akademiaelektroniki/steam-clock/doc/pcb/atomic_clk/atomic_clk.kicad_pcb

## KiCad design doc/pcb/atomic_clk/atomic_clk.kicad_pcb (2019-07-22)

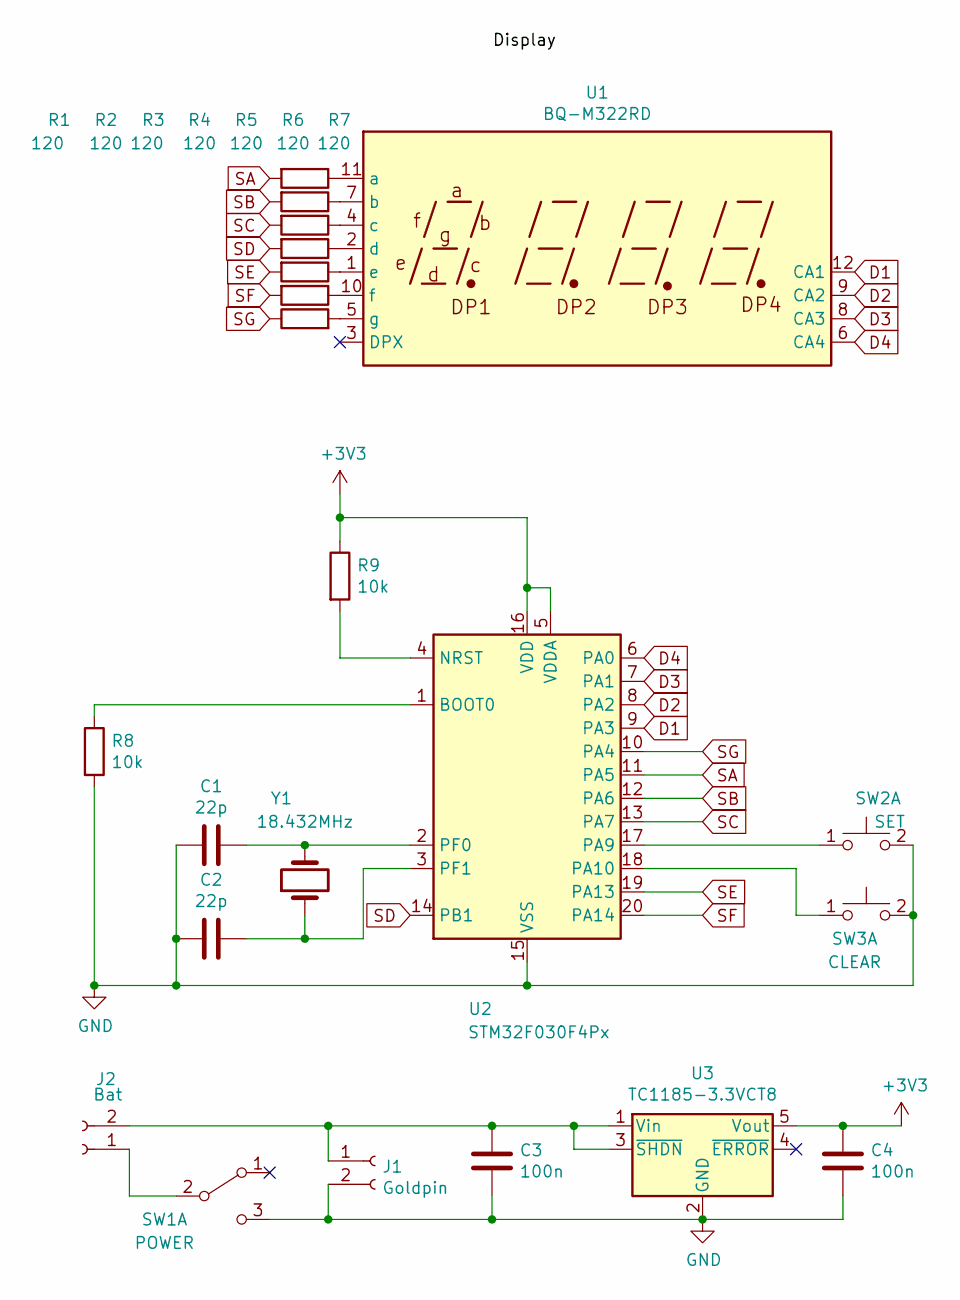
[picture p1: schematic atomic_clk.sch, Steam_Clock]

Parts:
C1, C2: 22p; C_0603_1608Metric_Pad1.05x0.95mm_HandSolder
C3, C4: 100n; C_0603_1608Metric_Pad1.05x0.95mm_HandSolder
J1: Goldpin; PinHeader_1x02_P2.54mm_Vertical
J2: Bat; PinHeader_1x02_P1.27mm_Vertical
R1, R2, R3, R4, R5, R6, R7: 120; R_0603_1608Metric
R8, R9: 10k; R_0603_1608Metric
SW1: POWER; SW_CuK_JS202011CQN_DPDT_Straight
SW2: SET; SW_SPST_CK_RS282G05A3
SW3: CLEAR; SW_SPST_CK_RS282G05A3
U1: BQ-M322RD; MAN3420A
U2: STM32F030F4Px; TSSOP-20_4.4x6.5mm_P0.65mm
U3: TC1185-3.3VCT8; SOT-23-5
Y1: 18.432MHz; Crystal_HC49-4H_Vertical

Connections:
+3V3: C4.1, R9.1, U2.5 (VDDA), U2.16 (VDD), U3.5 (Vout)
D1: U1.12 (CA1), U2.9 (PA3)
D2: U1.9 (CA2), U2.8 (PA2)
D3: U1.8 (CA3), U2.7 (PA1)
D4: U1.6 (CA4), U2.6 (PA0)
GND: C1.2, C2.2, C3.2, C4.2, J1.2, R8.2, SW1.3 (C), SW2.2 (D), SW3.2 (D), U2.15 (VSS), U3.2 (GND)
unnamed: C1.1, U2.2 (PF0), Y1.2
unnamed: C2.1, U2.3 (PF1), Y1.1
unnamed: C3.1, J1.1, J2.2, U3.1 (Vin), U3.3 (~SHDN)
unnamed: J2.1, SW1.2 (B)
unnamed: R1.1, U1.11 (a)
unnamed: R2.1, U1.7 (b)
unnamed: R3.1, U1.4 (c)
unnamed: R4.1, U1.2 (d)
unnamed: R5.1, U1.1 (e)
unnamed: R6.1, U1.10 (f)
unnamed: R7.2, U1.5 (g)
unnamed: R8.1, U2.1 (BOOT0)
unnamed: R9.2, U2.4 (NRST)
unnamed: SW2.1 (C), U2.17 (PA9)
unnamed: SW3.1 (C), U2.18 (PA10)
SA: R1.2, U2.11 (PA5)
SB: R2.2, U2.12 (PA6)
SC: R3.2, U2.13 (PA7)
SD: R4.2, U2.14 (PB1)
SE: R5.2, U2.19 (PA13)
SF: R6.2, U2.20 (PA14)
SG: R7.1, U2.10 (PA4)

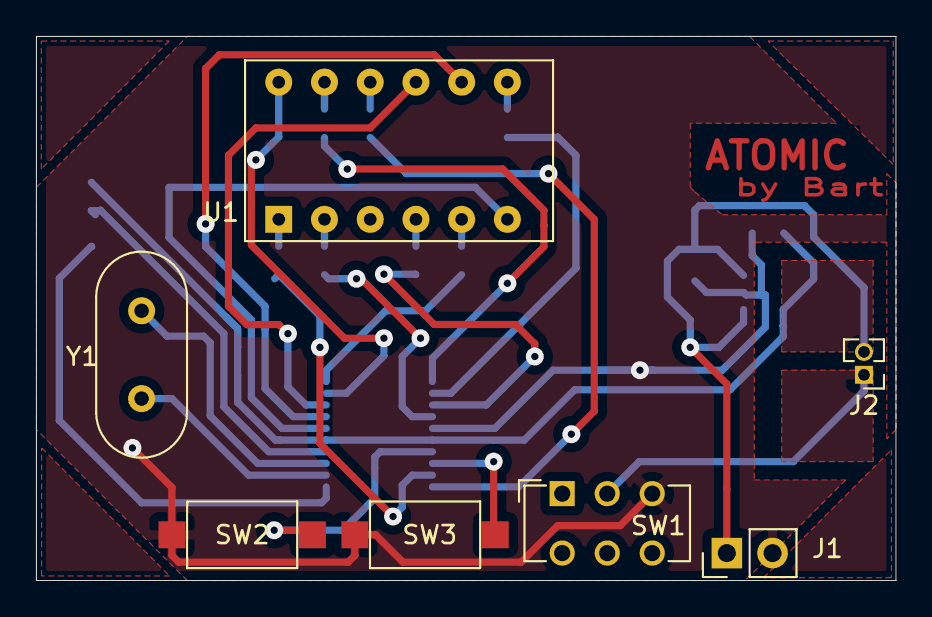
[picture p2: board atomic_clk.kicad_pcb from above]

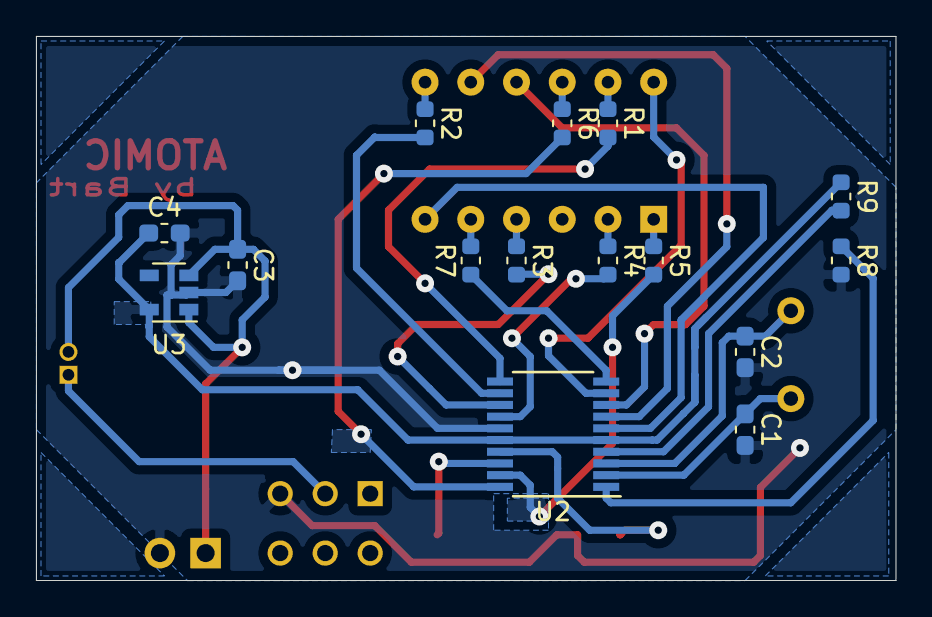
[picture p3: board atomic_clk.kicad_pcb from below]

Board: 2 copper layers, 47.8 x 30.2 mm, 22 parts (15 on the bottom side), 28 nets.
