akademiaelektroniki/steam-clock/Src/main.c

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

/* Includes ------------------------------------------------------------------*/
#include "main.h"

/* USER CODE BEGIN PTD */
RTC_TimeTypeDef gDate;
RTC_TimeTypeDef gTime;

RTC_TimeTypeDef sDate;
RTC_TimeTypeDef sTime;
/* USER CODE END PTD */

/* USER CODE BEGIN PD */

//Common anode display
//segments. dot is not user, so we have 7 segments, from A to G.
//Segments are cathodes, so you can turn it on by pulling to ground.
#define SA_ON HAL_GPIO_WritePin(SA_GPIO_Port, SA_Pin, 0)
#define SB_ON HAL_GPIO_WritePin(SB_GPIO_Port, SB_Pin, 0)
#define SC_ON HAL_GPIO_WritePin(SC_GPIO_Port, SC_Pin, 0)
#define SD_ON HAL_GPIO_WritePin(SD_GPIO_Port, SD_Pin, 0)
#define SE_ON HAL_GPIO_WritePin(SE_GPIO_Port, SE_Pin, 0)
#define SF_ON HAL_GPIO_WritePin(SF_GPIO_Port, SF_Pin, 0)
#define SG_ON HAL_GPIO_WritePin(SG_GPIO_Port, SG_Pin, 0)

#define SA_OFF HAL_GPIO_WritePin(SA_GPIO_Port, SA_Pin, 1)
#define SB_OFF HAL_GPIO_WritePin(SB_GPIO_Port, SB_Pin, 1)
#define SC_OFF HAL_GPIO_WritePin(SC_GPIO_Port, SC_Pin, 1)
#define SD_OFF HAL_GPIO_WritePin(SD_GPIO_Port, SD_Pin, 1)
#define SE_OFF HAL_GPIO_WritePin(SE_GPIO_Port, SE_Pin, 1)
#define SF_OFF HAL_GPIO_WritePin(SF_GPIO_Port, SF_Pin, 1)
#define SG_OFF HAL_GPIO_WritePin(SG_GPIO_Port, SG_Pin, 1)

//digits. We have 4, from 1 to 4. Digits are anodes, so you can turn it on by pulling
//to supply voltage
#define D1_ON HAL_GPIO_WritePin(D1_GPIO_Port, D1_Pin, 1)
#define D2_ON HAL_GPIO_WritePin(D2_GPIO_Port, D2_Pin, 1)
#define D3_ON HAL_GPIO_WritePin(D3_GPIO_Port, D3_Pin, 1)
#define D4_ON HAL_GPIO_WritePin(D4_GPIO_Port, D4_Pin, 1)

#define D1_OFF HAL_GPIO_WritePin(D1_GPIO_Port, D1_Pin, 0)
#define D2_OFF HAL_GPIO_WritePin(D2_GPIO_Port, D2_Pin, 0)
#define D3_OFF HAL_GPIO_WritePin(D3_GPIO_Port, D3_Pin, 0)
#define D4_OFF HAL_GPIO_WritePin(D4_GPIO_Port, D4_Pin, 0)

//turning off
#define D_OFF D1_OFF; D2_OFF; D3_OFF; D4_OFF
#define S_OFF SA_OFF; SB_OFF; SC_OFF; SD_OFF; SE_OFF; SF_OFF; SG_OFF
#define ALL_OFF D_OFF; S_OFF

//display delay
#define WAIT HAL_Delay(1)

//buttons
#define CLEAR HAL_GPIO_ReadPin(CLEAR_GPIO_Port, CLEAR_Pin) == 0
#define SET HAL_GPIO_ReadPin(SET_GPIO_Port, SET_Pin) == 0

/* USER CODE END PD */

RTC_HandleTypeDef hrtc;

/* USER CODE BEGIN PV */
int hours;
int minutes;
int seconds;
int settings = 0; //settings mode
int set_delay = 100;
int active_time = 0;
int mode = 1; //0- force, 1- ondemand
/* USER CODE END PV */

void SystemClock_Config(void);
static void MX_GPIO_Init(void);
static void MX_RTC_Init(void);
/* USER CODE BEGIN PFP */
void display(int position, int number);
void display_twice(int position, int number);
/* USER CODE END PFP */

/**
  * @brief  The application entry point.
  * @retval int
  */
int main(void)
{
  /* MCU Configuration--------------------------------------------------------*/

  /* Reset of all peripherals, Initializes the Flash interface and the Systick. */
  HAL_Init();

  /* Configure the system clock */
  SystemClock_Config();

  /* Initialize all configured peripherals */
  MX_GPIO_Init();
  MX_RTC_Init();
  /* Infinite loop */
  /* USER CODE BEGIN WHILE */
	while (1) {
	
	if(SET){
	
		active_time = 0;
		HAL_Delay(50);

	}

	while(active_time < 10 || mode == 0){
		//___________________SECTION 1 -setting clock

		if (CLEAR) { //clear button enter clock set.
			settings = 1;
			HAL_Delay(300);

		}
		//if set are bigger than 0, you are entering setting mode.
		while (settings >= 1) {

			if (CLEAR) {
				settings++;
				if (settings >= 5) {
					settings = 0;
				}
				HAL_Delay(300);
			}

			//reading from RTC also in settings mode
			HAL_RTC_GetDate(&hrtc, &gDate, RTC_FORMAT_BIN);
			HAL_RTC_GetTime(&hrtc, &gTime, RTC_FORMAT_BIN);
			hours = gTime.Hours;
			minutes = gTime.Minutes;
			seconds = gTime.Seconds;

			//display ony this, what you are setting
			if (settings == 1) {
				display_twice(1, hours);
			} else if (settings == 2) {
				display_twice(3, minutes);
			} else if (settings == 3) {
				display_twice(3, seconds);
			} else if (settings == 4){
				
				if(mode == 0){
					
					display(2, 10);

				}else if(mode == 1){

					display(2, 11);
				}
			}

			ALL_OFF
			;

			if (settings == 1) {
				if (SET) {
					hours++;
					if (hours >= 24) {
						hours = 0;

					}

					sTime.Hours = hours;
					sTime.Minutes = minutes;
					sTime.Seconds = seconds;
					HAL_RTC_SetDate(&hrtc, &sDate, RTC_FORMAT_BIN);
					HAL_RTC_SetTime(&hrtc, &sTime, RTC_FORMAT_BIN);
					HAL_Delay(set_delay);

				}
			}

			if (settings == 2) {
				if (SET) {
					minutes++;
					if (minutes >= 60) {
						minutes = 0;

					}

					sTime.Hours = hours;
					sTime.Minutes = minutes;
					sTime.Seconds = seconds;
					HAL_RTC_SetDate(&hrtc, &sDate, RTC_FORMAT_BIN);
					HAL_RTC_SetTime(&hrtc, &sTime, RTC_FORMAT_BIN);
					HAL_Delay(set_delay);

				}
			}

			if (settings == 3) {
				if (SET) {
					seconds = 0;
					sTime.Hours = hours;
					sTime.Minutes = minutes;
					sTime.Seconds = seconds;
					HAL_RTC_SetDate(&hrtc, &sDate, RTC_FORMAT_BIN);
					HAL_RTC_SetTime(&hrtc, &sTime, RTC_FORMAT_BIN);
					HAL_Delay(set_delay);

				}

			}

			if(settings ==4){
				
				if(SET) {
					if(mode == 0){
					
						mode = 1;

					}else if(mode == 1){

						mode = 0;
					
					}
					HAL_Delay(set_delay);
				}
			}
		}

		//___________________SECTION 2 -display clock
		if (SET) {
			display_twice(3, seconds);
			active_time = 0;//reset active time when pressed
		} else {
			display_twice(1, hours);
			display_twice(3, minutes);
		}

		//___________________SECTION 3 -read from RTC
		


		HAL_RTC_GetDate(&hrtc, &gDate, RTC_FORMAT_BIN);
		HAL_RTC_GetTime(&hrtc, &gTime, RTC_FORMAT_BIN);
		
		//after each second counter change, add 1 to counter variable
		//except settings mode and seconds check
		if(seconds != gTime.Seconds && settings == 0 && !SET){

			active_time++;

		}

		hours = gTime.Hours;
		minutes = gTime.Minutes;
		seconds = gTime.Seconds;

		//___________________SECTION 4 -exit active mode

	}

    /* USER CODE END WHILE */

    /* USER CODE BEGIN 3 */
	}
  /* USER CODE END 3 */
}

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
/* USER CODE BEGIN 4 */
void display(int position, int number) {
	ALL_OFF
	;
	int ok = 1;
	switch (position) {
	case 1:
		D1_ON;
		break;
	case 2:
		D2_ON;
		break;
	case 3:
		D3_ON;
		break;
	case 4:
		D4_ON;
		break;
	default:
		ok = 0;		//secure. Dont turn LEDs, if position is different than 1-4
	}
	if (ok == 1) {
		switch (number) {
		case 0:
			SA_ON;
			SB_ON;
			SC_ON;
			SD_ON;
			SE_ON;
			SF_ON;
			break;
		case 1:
			SB_ON;
			SC_ON;
			break;
		case 2:
			SA_ON;
			SB_ON;
			SG_ON;
			SE_ON;
			SD_ON;
			break;
		case 3:
			SA_ON;
			SB_ON;
			SG_ON;
			SC_ON;
			SD_ON;
			break;

		case 4:
			SB_ON;
			SG_ON;
			SF_ON;
			SC_ON;
			break;
		case 5:
			SA_ON;
			SF_ON;
			SG_ON;
			SC_ON;
			SD_ON;
			break;

		case 6:
			SA_ON;
			SF_ON;
			SG_ON;
			SC_ON;
			SE_ON;
			SD_ON;
			break;

		case 7:
			SA_ON;
			SB_ON;
			SC_ON;
			break;

		case 8:
			SA_ON;
			SB_ON;
			SC_ON;
			SD_ON;
			SE_ON;
			SF_ON;
			SG_ON;
			break;

		case 9:
			SA_ON;
			SB_ON;
			SC_ON;
			SD_ON;
			SG_ON;
			SF_ON;
			break;

		case 10://F letter(force mode)
			SA_ON;
			SG_ON;
			SE_ON;
			SF_ON;
			break;

		case 11://O letter(ondemand mode)
			SA_ON;
			SB_ON;
			SC_ON;
			SD_ON;
			SE_ON;
			SF_ON;
			break;


		}
	}
	WAIT;
	ALL_OFF;
}

void display_twice(int position, int number) {
	int first_digit;
	int second_digit;
	ALL_OFF
	;
//brake a number into two digits
	if (number <= 9) {
		first_digit = 0;
		second_digit = number;
	}
	if ((number >= 10) && (number <= 19)) {		//check if number is from range
		first_digit = 1;
		second_digit = number - 10;
	}
	if ((number >= 20) && (number <= 29)) {		//check if number is from range
		first_digit = 2;
		second_digit = number - 20;
	}
	if ((number >= 30) && (number <= 39)) {		//check if number is from range
		first_digit = 3;
		second_digit = number - 30;
	}
	if ((number >= 40) && (number <= 49)) {		//check if number is from range
		first_digit = 4;
		second_digit = number - 40;
	}
	if ((number >= 50) && (number <= 59)) {		//check if number is from range
		first_digit = 5;
		second_digit = number - 50;
	}

	display(position, first_digit);
	display(position + 1, second_digit);

}
/* USER CODE END 4 */
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
