akademiaelektroniki/steam-clock/10_STEAM_CLK.ioc

Mcu.UserName=STM32F030F4Px
PA0.GPIO_Label=D4
PA0.Signal=GPIO_Output
PA1.GPIO_Label=D3
PA1.Signal=GPIO_Output
PA10.GPIO_Label=CLEAR
PA10.Signal=GPIO_Input
PA13.GPIO_Label=SE
PA13.Signal=GPIO_Output
PA14.GPIO_Label=SF
PA14.Signal=GPIO_Output
PA2.GPIO_Label=D2
PA2.Signal=GPIO_Output
PA3.GPIO_Label=D1
PA3.Signal=GPIO_Output
PA4.GPIO_Label=SG
PA4.Signal=GPIO_Output
PA5.GPIO_Label=SA
PA5.Signal=GPIO_Output
PA6.GPIO_Label=SB
PA6.Signal=GPIO_Output
PA7.GPIO_Label=SC
PA7.Signal=GPIO_Output
PA9.GPIO_Label=SET
PA9.Signal=GPIO_Input
PB1.GPIO_Label=SD
PB1.Signal=GPIO_Output
PF0-OSC_IN.Signal=RCC_OSC_IN
PF1-OSC_OUT.Signal=RCC_OSC_OUT
