akademiaelektroniki/steam-clock/(commit log)

2019-07-10 zmiana nazwy dokumentacji
    [steam_clk.kicad_pcb, steam_clk.sch]
2019-07-11 added PCB to license
2019-07-12 added name on PCB
    [steam_clk.kicad_pcb]
2019-07-12 added places for cage
    [steam_clk.kicad_pcb]
2019-07-15 better tracks on pcb
    [4x.kicad_pcb, steam_clk.kicad_pcb, steam_clk.sch]
2019-07-15 dodana wersja daily, uaktualnione footprinty przycisków
    [daily_clk.kicad_pcb, daily_clk.sch]
2019-07-15 atomic board
    [daily_clk.kicad_pcb, steam_clk.kicad_pcb]
2019-07-15 atomic update
    [4x.kicad_pcb, atomic_clk.kicad_pcb.kicad_pcb]
2019-07-16 przygotowanie pod nowy akumulator
    [atomic_clk.kicad_pcb, atomic_clk.kicad_pcb.kicad_pcb, atomic_clk.sch]
2019-07-16 jst conetor
    [atomic_clk.kicad_pcb, atomic_clk.sch]
2019-07-16 better colors
    [atomic_clk.kicad_pcb]
2019-07-17 better pathm replaced uc
    [atomic_clk.kicad_pcb]
2019-07-17 zminimalizowana ilość przelotek
    [atomic_clk.kicad_pcb]
2019-07-18 correct pads for battery
    [10_STEAM_CLK Run.cfg, 4x.kicad_pcb, atomic_clk.kicad_pcb]
2019-07-21 folder name changes
    [4x.kicad_pcb, atomic_clk.kicad_pcb, atomic_clk.sch, steam_clk.kicad_pcb, steam_clk.sch]
2019-07-22 better pad
    [atomic_clk.kicad_pcb]
